danielszark/textiles-chaos-hoodie/images/img2.jpg

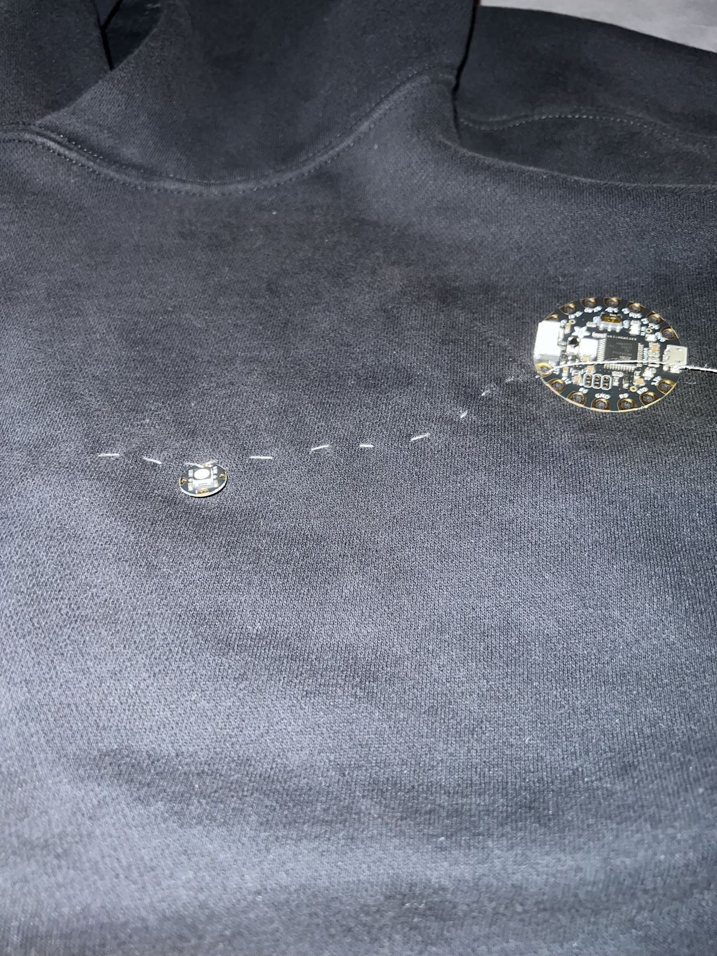
images/img2.jpg
