danielszark/textiles-chaos-hoodie/images/img3.jpg

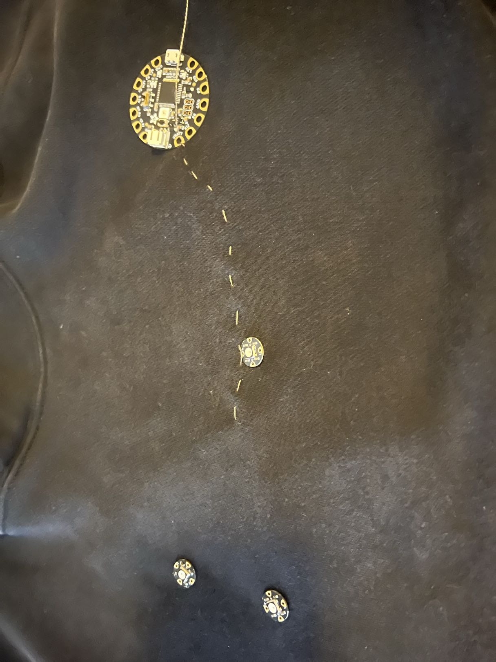
images/img3.jpg
