danielszark/textiles-chaos-hoodie/images/img4.jpg

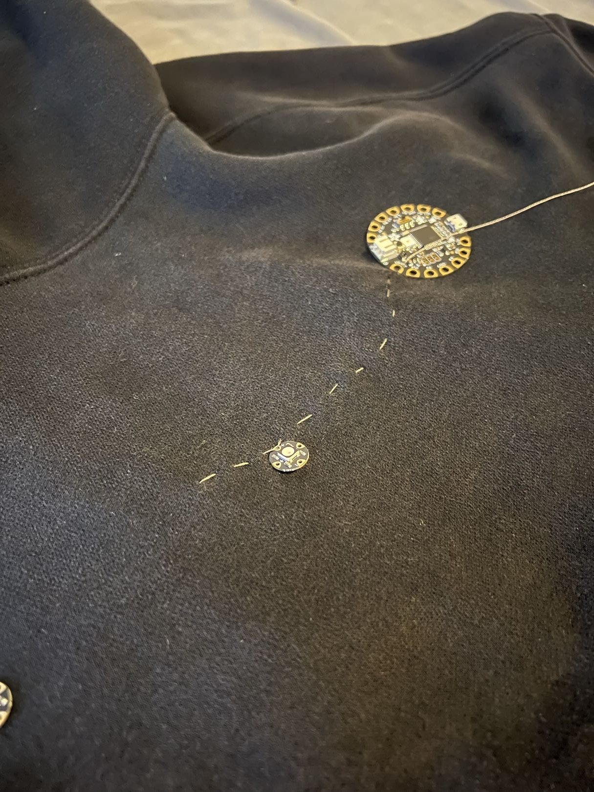
images/img4.jpg
