danielszark/textiles-chaos-hoodie/images/img6.jpg

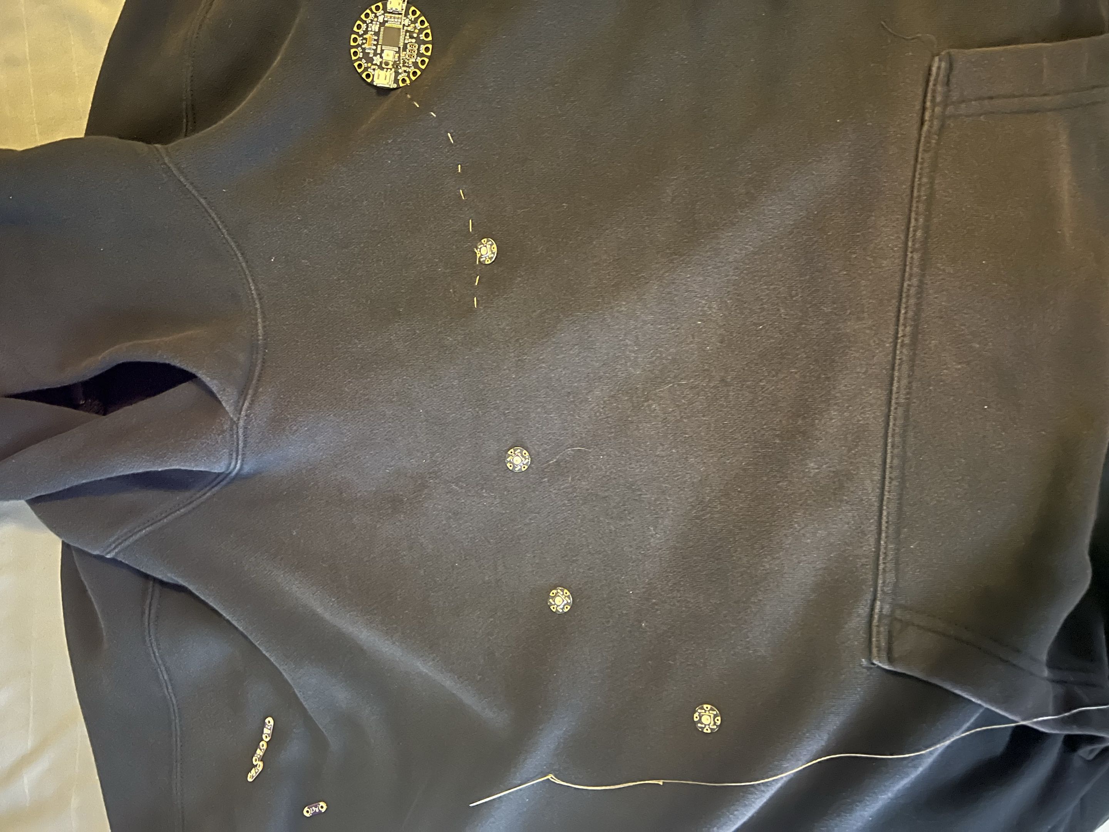
images/img6.jpg
