danielszark/textiles-chaos-hoodie/images/img7.jpg

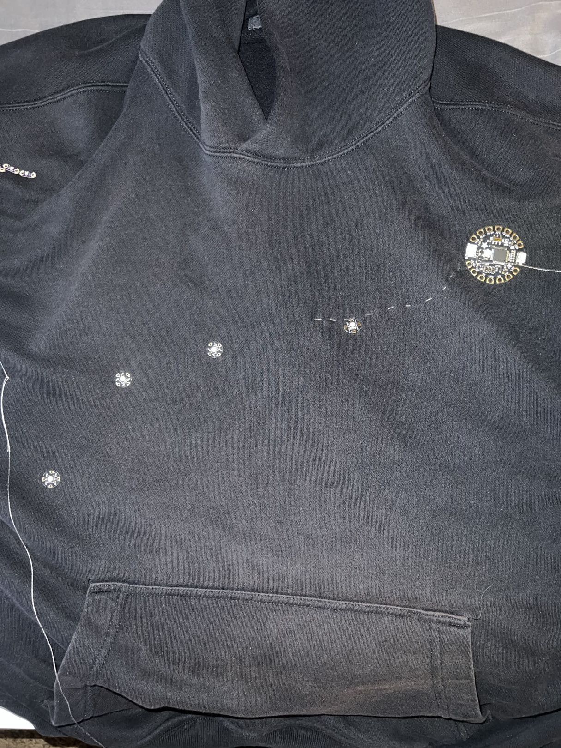
images/img7.jpg
