danielszark/textiles-chaos-hoodie/images/img8.jpg

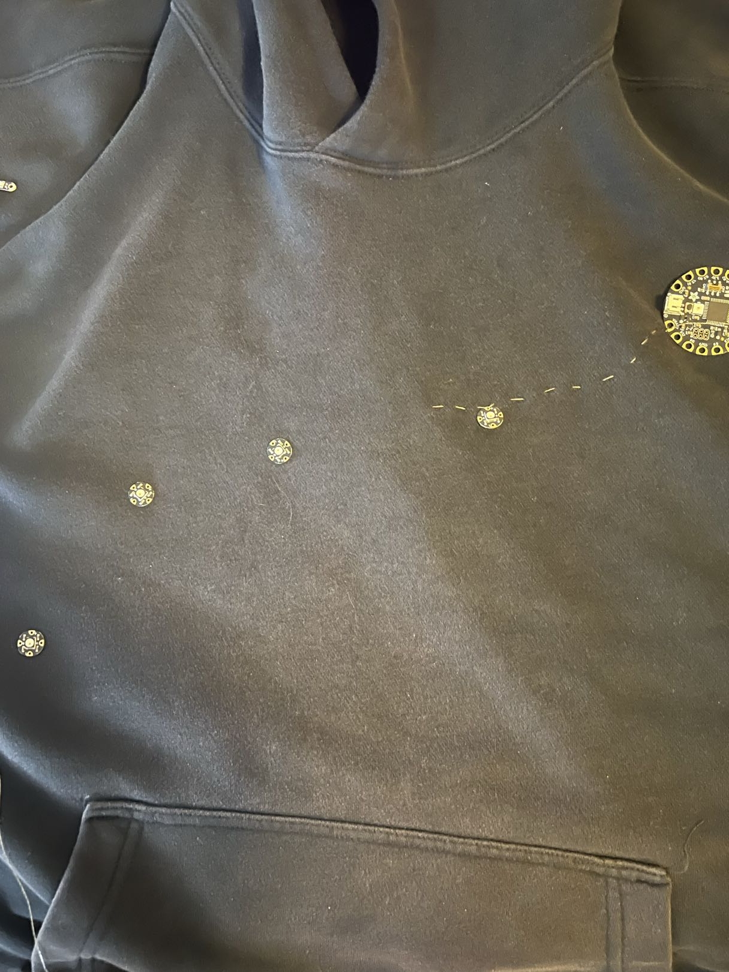
images/img8.jpg
