danielszark/textiles-chaos-hoodie/images/img9.jpg

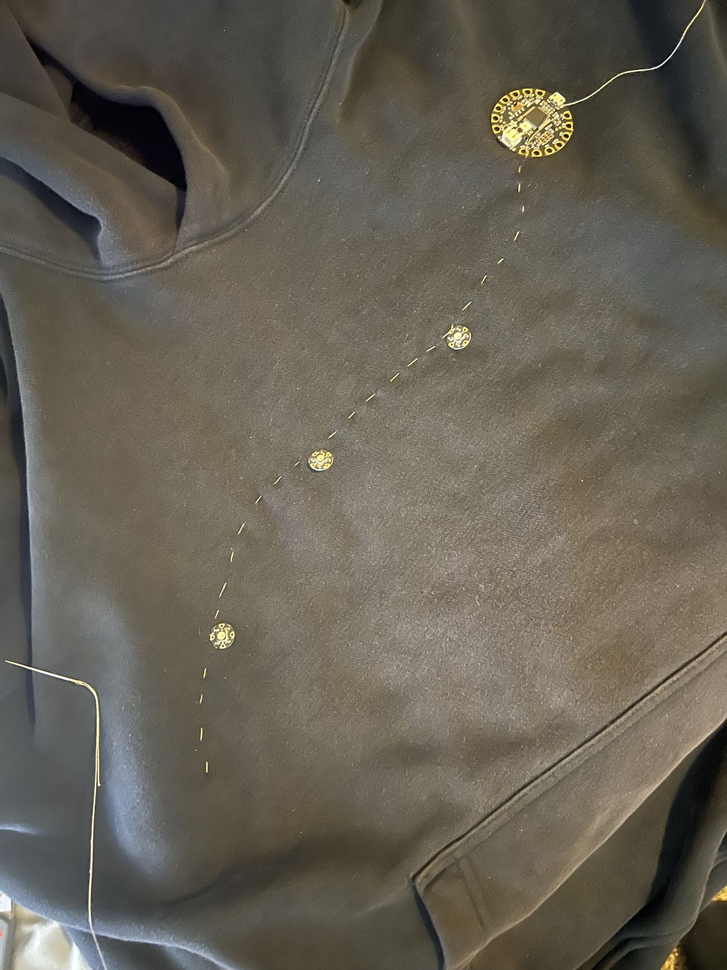
images/img9.jpg
