danielszark/textiles-chaos-hoodie/images/img14.jpg

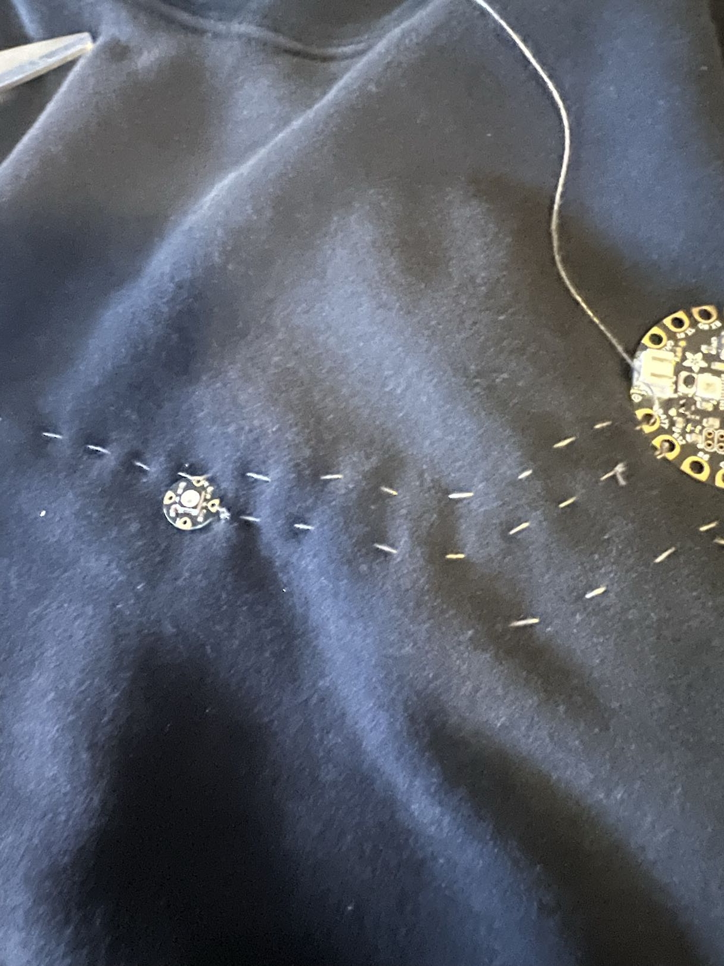
images/img14.jpg
