danielszark/textiles-chaos-hoodie/images/img20.jpg

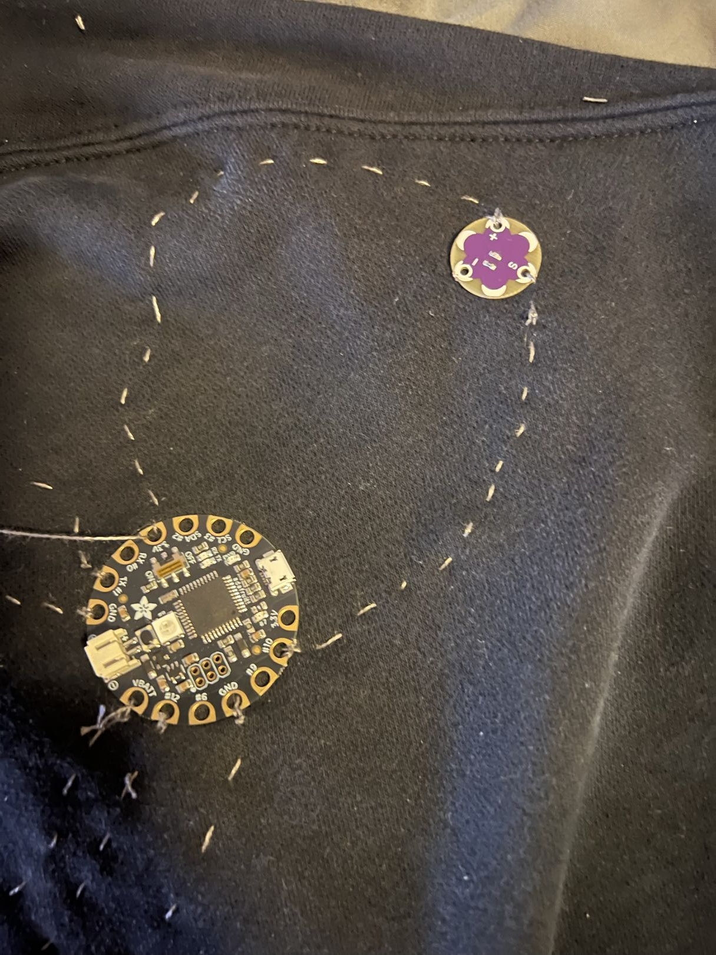
images/img20.jpg
