danielszark/textiles-chaos-hoodie/images/img22.jpg

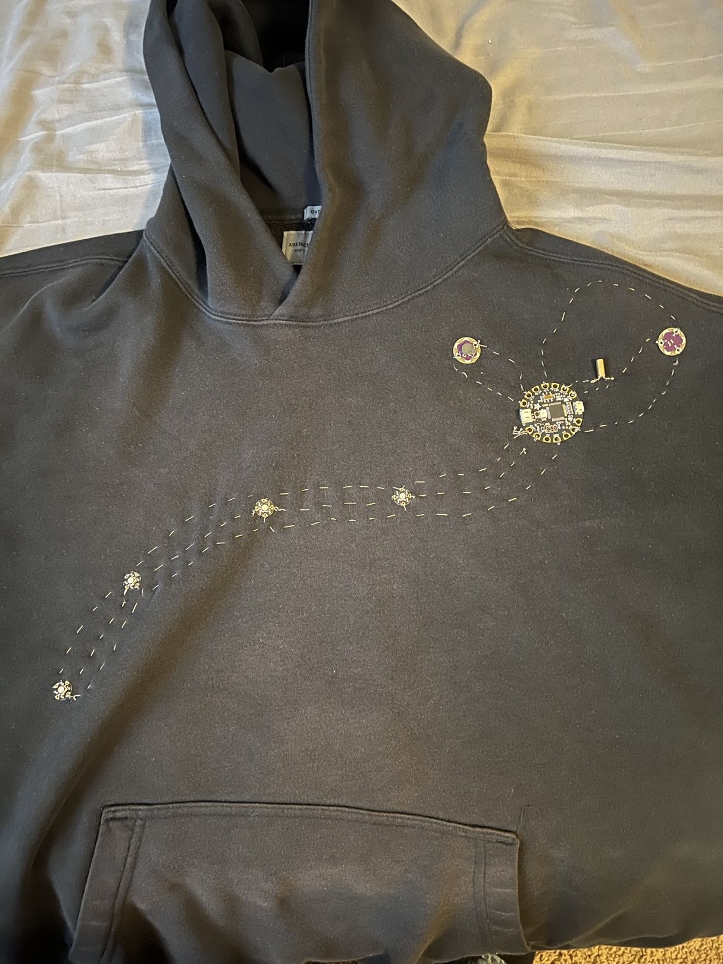
images/img22.jpg
